ExploreEmbedded/Ultra--AT89S52-Development-Board_DVB-11001/Ultra 8051 Development Board V1.1_BOM .xls

Id | Designation | Designator | Package |  | Quantity
1 | 32.768KHz Crystal | X1 | Through hole | 1 | 50
2 | 10K Trim Pot (Blue and white) | RV1,RV3 | RM-065-103 | 2 | 100
3 | USB Type B Right angle Female | J1 | USB type B Through hole | 1 | 50
4 | DC Power Jack | K4 | Through hole | 1 | 50
5 | 40 pin ZIP Socket | U7 | DIP-40 | 1 | 50
6 | 10K Resistor Array ( 9 pin) | RR6,RR4,RR2,RR3 | SIL-9 TH | 4 | 200
7 | 1K Resistor, 5% , 0.25W | R8,R7,R6,R5,R9,R10,R12 | Through hole | 7 | 350
8 | 0.1uF Capacitor (Disc) | C3,C4,C7 | Through hole | 3 | 150
9 | 22pF Capacitor (Disc) | C12,C11 | Through hole | 2 | 100
10 | 100uF/25V Capacitor | C2 | Electrolytic , TH | 1 | 50
11 | 1000uF/25V Capacitor | C1 | Electrolytic , TH | 1 | 50
12 | IN4007 Diode | D6,D5,D16 | Through hole | 3 | 150
13 | 16 Pin IC Base | IC1 | DIP 16 | 1 | 50
14 | RED LED | D3,D13,D12,D11,D10,D9,D8,D7,D14,D15,D2,D4 | LED-5MM | 12 | 600
15 | 470E Resistor, 5% , 0.25W | R2,R16,R27 | Through hole | 3 | 150
16 | 10K Resistor, 5% , 0.25W | R1,R17,R26 | Through hole | 3 | 150
17 | 2.2K Resistor, 5% , 0.25W | R19 | Through hole | 1 | 50
18 | 220E Resistor, 5% , 0.25W | R18,R13 | Through hole | 2 | 100
19 | LM35 Sensor | RV2 | TO-92 | 1 | 50
25 | 40Pin Male header | P13 | Through hole | 1 | 1pack
26 | Momentary Push tactile switch (12mm X 12mm X 8mm)big | SW18 | 4 pin Through hole | 1 | 50
27 | 1.5A Bridge Rectifier | D1 | 4 pin Through hole | 1 | 50
28 | 8 pin DIP Switch | S1 | DIP-16 | 1 | 50
29 | 16 pin Female header Straight | LCD1 | SIL-16 | 1 | 50
30 | 40 pin IC Base | AFF1,AFF2,AFF3,AFF4 | DIP-40 | 4 | 200
31 | 11.0592MHz Crystal | X3 | Through hole | 1 | 50
32 | 2Pin Push Tactile switch(Small round ) | SW2,SW3,SW4,SW5,SW6,SW7,SW8,SW9,SW10,SW11,SW12,SW13,SW14,SW15,SW16,SW17,SW19,SW20 | Through hole | 18 | 900
33 | Verticle 3 pin slide switch | SW1 | Through hole | 1 | 50
34 | LM7805 Regulator | U1 | TO-220 | 1 | 50
35 | 5V/10A Sugar Cube Relay (Black clolor) | K2,K1 | 5pin Through hole | 2 | 100
36 | Magnatic buzzer Small | SG1 | Through hole | 1 | 50
37 | Transistor BC557 | Q1 | TO92 | 1 | 50
38 | 4.7K Resistor, 5% , 0.25W | R11 | R4 | 1 | 50
39 | CP2102 | U10 | QFN-28 | 1 | 50
40 | Transistor BC548 | Q8,Q7,Q5,Q4,Q6,Q2,Q3 | TO92 | 7 | 350
41 | 7Pin Male header | P18 | Through hole | 1 | 50
42 | 3.3K Resistor, 5% , 0.25W | R14,R15,R4,R3, | Through hole | 4 | 200
43 | 2.2K Resistor, 5% , 0.25W | R20 | Through hole | 1 | 50
44 | 68E Resistor, 5% , 0.25W | R24,R23,R22,R21 | R4 | 4 | 200
45 | LDR | R25 | Through hole | 1 | 50
46 | 2 pin BBT Connetor | JP9,JP8 | MKDSN | 2 | 100
47 | 10 pin Right angle Box header(5X2) | P5 | Through hole | 1 | 50
48 | 8 pin IC Base | U2,U3,u5 | DIP-8 | 3 | 150
49 | Coin cell Battery holder(CR2032) | U4 | Through hole | 1 | 50
50 | 3 pin BBT Connector | JP2,JP3 | MKDSN | 2 | 100
51 | 28 Pin IC Base Wide | U6 | Broad DIP-28 | 1 | 50
52 | Heat sink TO-220 | HT1 | 2 Mounting hole | 1 | 50
 | IC's and other component
 | AT89S52 | U7 | DIP-40 | 1 | 50
 | ADC0809CCN | U6 | N28B | 1 | 50
 | 16X2 Green LCD | LCD1 | HD4470 based LCD | 1 | 10
 | Seven Segment ( 0.56") Common Anode | AFF1,AFF2,AFF3,AFF4 | 0.56" , TH | 4 | 200
 | CR2032 Coin cell | U4 |  | 1 | 50
 | 12V, 1A Adaptor |  |  |  | 50
