ExploreEmbedded/Ultra--AT89S52-Development-Board_DVB-11001/Ultra_DB_X51_v1.kicad_pcb

## KiCad design Ultra_DB_X51_v1.kicad_pcb (2016-12-07)

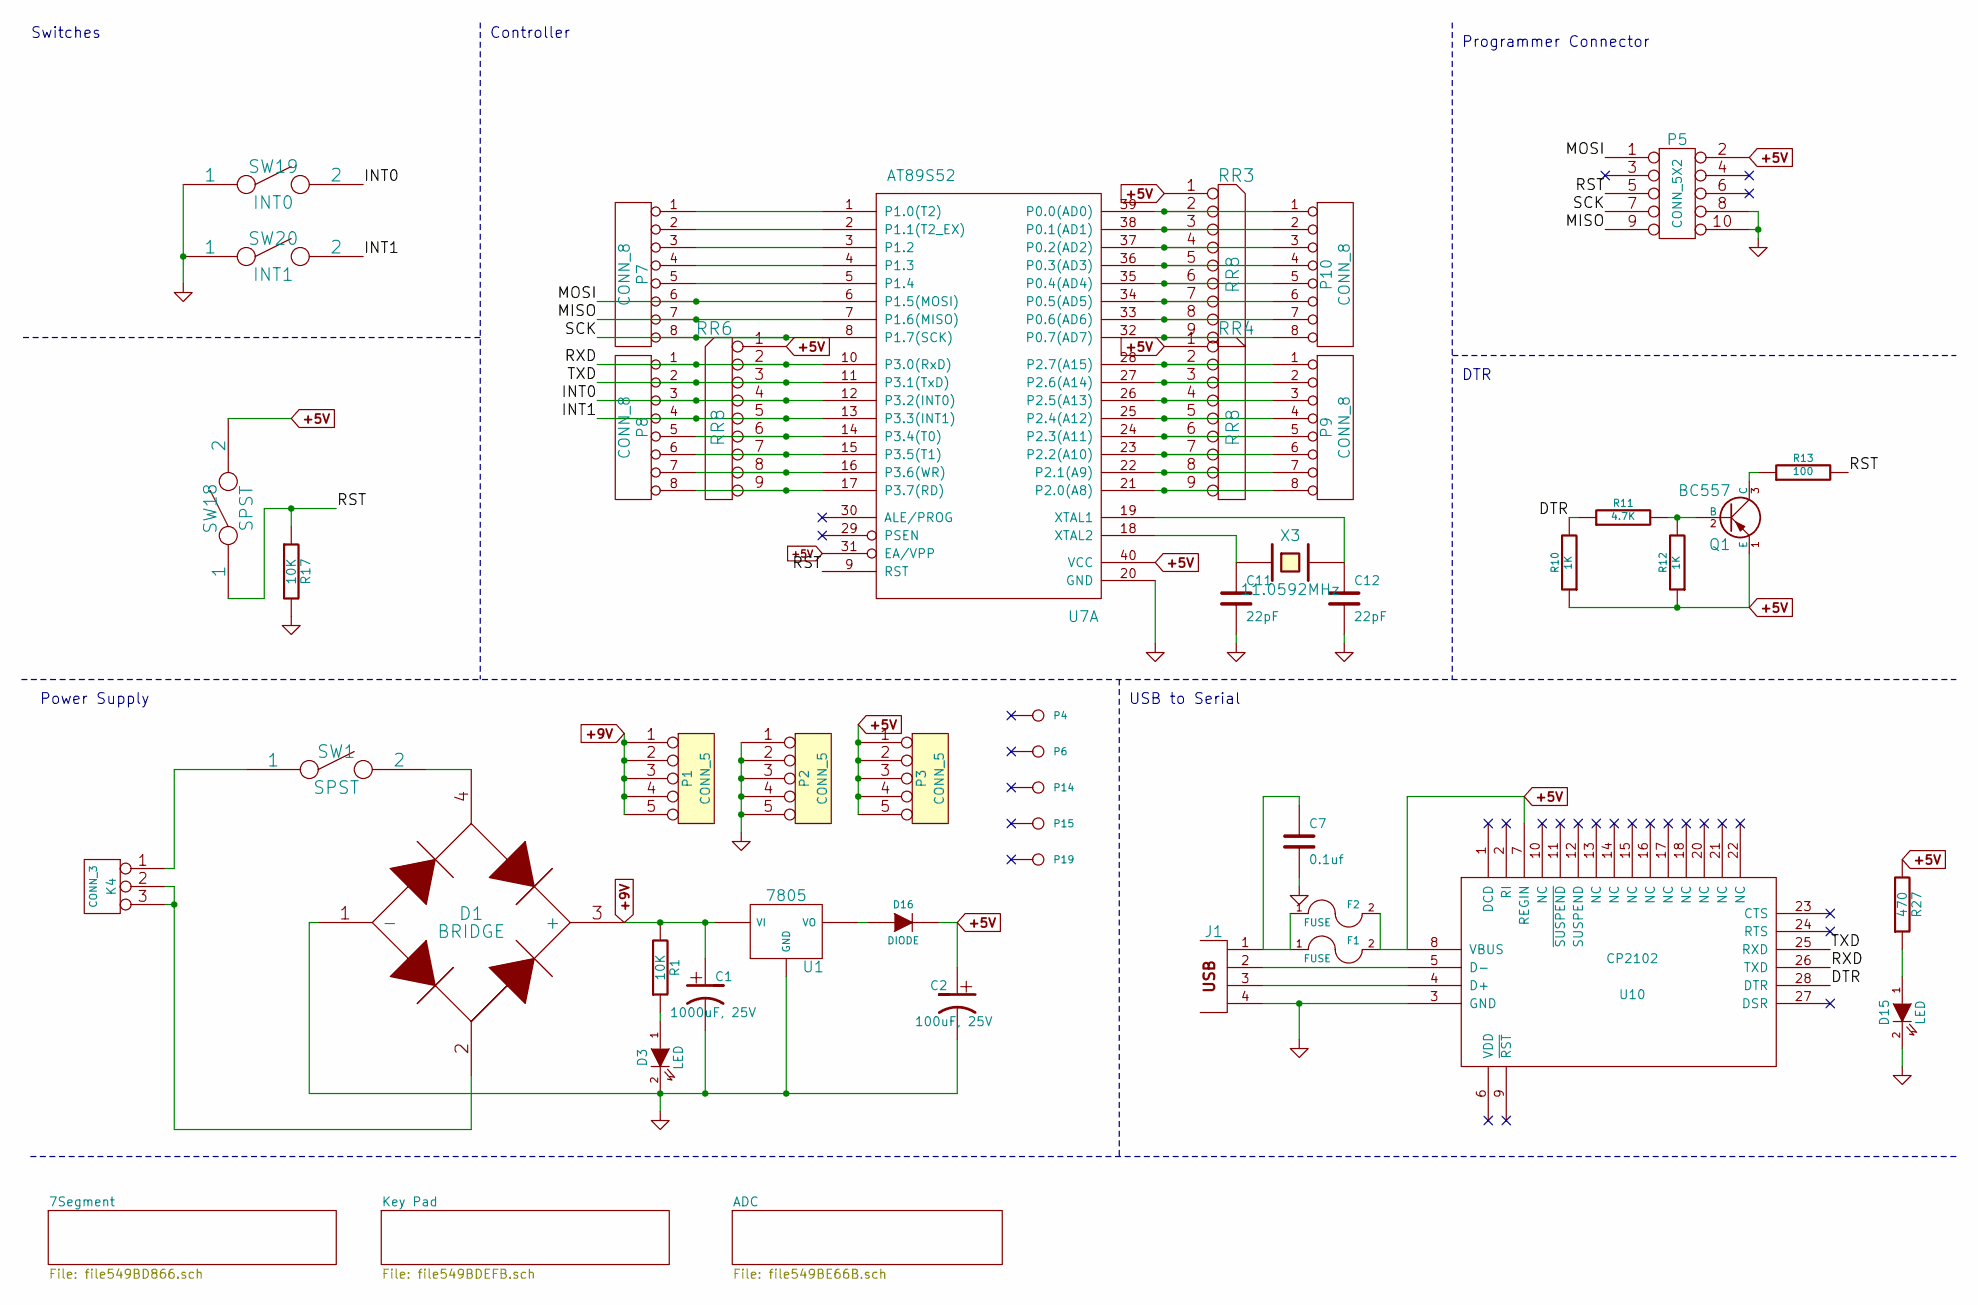
[picture p1: schematic Ultra_DB_X51_v1.sch, Schematic_Ultra_X51]

Parts:
C1: 1000uF, 25V
C2: 100uF, 25V
C7: 0.1uf
C11, C12: 22pF
D1: BRIDGE
D3, D15: LED
D16: DIODE
F1, F2: FUSE
J1: USB_2
K4: CONN_3
P1, P2, P3: CONN_5
P4, P6, P14, P15, P19: CONN_1
P5: CONN_5X2
P7, P8, P9, P10: CONN_8
Q1: BC557
R1, R17: 10K
R10, R12: 1K
R11: 4.7K
R13: 100
R27: 470
RR3, RR4, RR6: RR8
SW1, SW18: SPST
SW19: INT0
SW20: INT1
U1: 7805
U7: AT89S52
U10: CP2102; MODULE
X3: 11.0592MHz

Connections:
+5V: C2.1, D16.2 (K), F1.2, F2.2, P3.1, P3.2, P3.3, P3.4, P3.5, P5.2, Q1.1 (E), R10.1, R12.1, R27.2, RR3.1 (COM), RR4.1 (COM), RR6.1 (COM), SW18.2, U7.31 (EA/VPP), U7.40 (VCC), U10.7 (REGIN), U10.8 (VBUS); also elsewhere on the board
+9V: C1.1, D1.3 (+), P1.1, P1.2, P1.3, P1.4, P1.5, R1.2, U1.VI; also elsewhere on the board
/DTR: R10.2, R11.1, U10.28 (DTR)
/INT0: P8.3, RR6.4, SW19.2, U7.12 (P3.2(INT0))
/INT1: P8.4, RR6.5, SW20.2, U7.13 (P3.3(INT1))
/MISO: P5.9, P7.7, U7.7 (P1.6(MISO))
/MOSI: P5.1, P7.6, U7.6 (P1.5(MOSI))
/RST: P5.5, R13.2, R17.1, SW18.1, U7.9 (RST)
/RXD: P8.1, RR6.2, U7.10 (P3.0(RxD)), U10.26 (TXD)
/SCK: P5.7, P7.8, U7.8 (P1.7(SCK))
/TXD: P8.2, RR6.3, U7.11 (P3.1(TxD)), U10.25 (RXD)
GND: C1.2, C2.2, C7.2, C11.2, C12.2, D1.1 (-), D3.2 (K), D15.2 (K), J1.4, P2.1, P2.2, P2.3, P2.4, P2.5, P5.8, P5.10, R17.2, SW19.1, SW20.1, U1.GND, U7.20 (GND), U10.3 (GND); also elsewhere on the board
unnamed: J1.2, U10.5 (D-)
unnamed: Q1.2 (B), R11.2, R12.2
unnamed: J1.3, U10.4 (D+)
unnamed: Q1.3 (C), R13.1
unnamed: C7.1, F1.1, F2.1, J1.1
unnamed: D1.2, K4.2 (PM), K4.3
unnamed: P7.5, U7.5 (P1.4)
unnamed: P7.4, U7.4 (P1.3)
unnamed: P7.3, U7.3 (P1.2)
unnamed: P7.2, U7.2 (P1.1(T2_EX))
unnamed: P7.1, U7.1 (P1.0(T2))
unnamed: D16.1 (A), U1.VO
unnamed: C12.1, U7.19 (XTAL1), X3.2
unnamed: C11.1, U7.18 (XTAL2), X3.1
unnamed: D3.1 (A), R1.1
unnamed: D15.1 (A), R27.1
unnamed: K4.1, SW1.1
unnamed: D1.4, SW1.2
unnamed: P8.5, RR6.6, U7.14 (P3.4(T0))
unnamed: P8.8, RR6.9, U7.17 (P3.7(RD))
unnamed: P8.7, RR6.8, U7.16 (P3.6(WR))
unnamed: P8.6, RR6.7, U7.15 (P3.5(T1))
unnamed: P9.8, RR4.9, U7.21 (P2.0(A8))
unnamed: P9.7, RR4.8, U7.22 (P2.1(A9))
unnamed: P9.6, RR4.7, U7.23 (P2.2(A10))
unnamed: P9.5, RR4.6, U7.24 (P2.3(A11))
unnamed: P9.4, RR4.5, U7.25 (P2.4(A12))
unnamed: P9.3, RR4.4, U7.26 (P2.5(A13))
unnamed: P9.2, RR4.3, U7.27 (P2.6(A14))
unnamed: P9.1, RR4.2, U7.28 (P2.7(A15))
unnamed: P10.2, RR3.3, U7.38 (P0.1(AD1))
unnamed: P10.8, RR3.9, U7.32 (P0.7(AD7))
unnamed: P10.7, RR3.8, U7.33 (P0.6(AD6))
unnamed: P10.6, RR3.7, U7.34 (P0.5(AD5))
unnamed: P10.5, RR3.6, U7.35 (P0.4(AD4))
unnamed: P10.4, RR3.5, U7.36 (P0.3(AD3))
unnamed: P10.3, RR3.4, U7.37 (P0.2(AD2))
unnamed: P10.1, RR3.2, U7.39 (P0.0(AD0))

Notes on the sheet:
Switches
Controller
Programmer Connector
DTR
USB to Serial
Power Supply

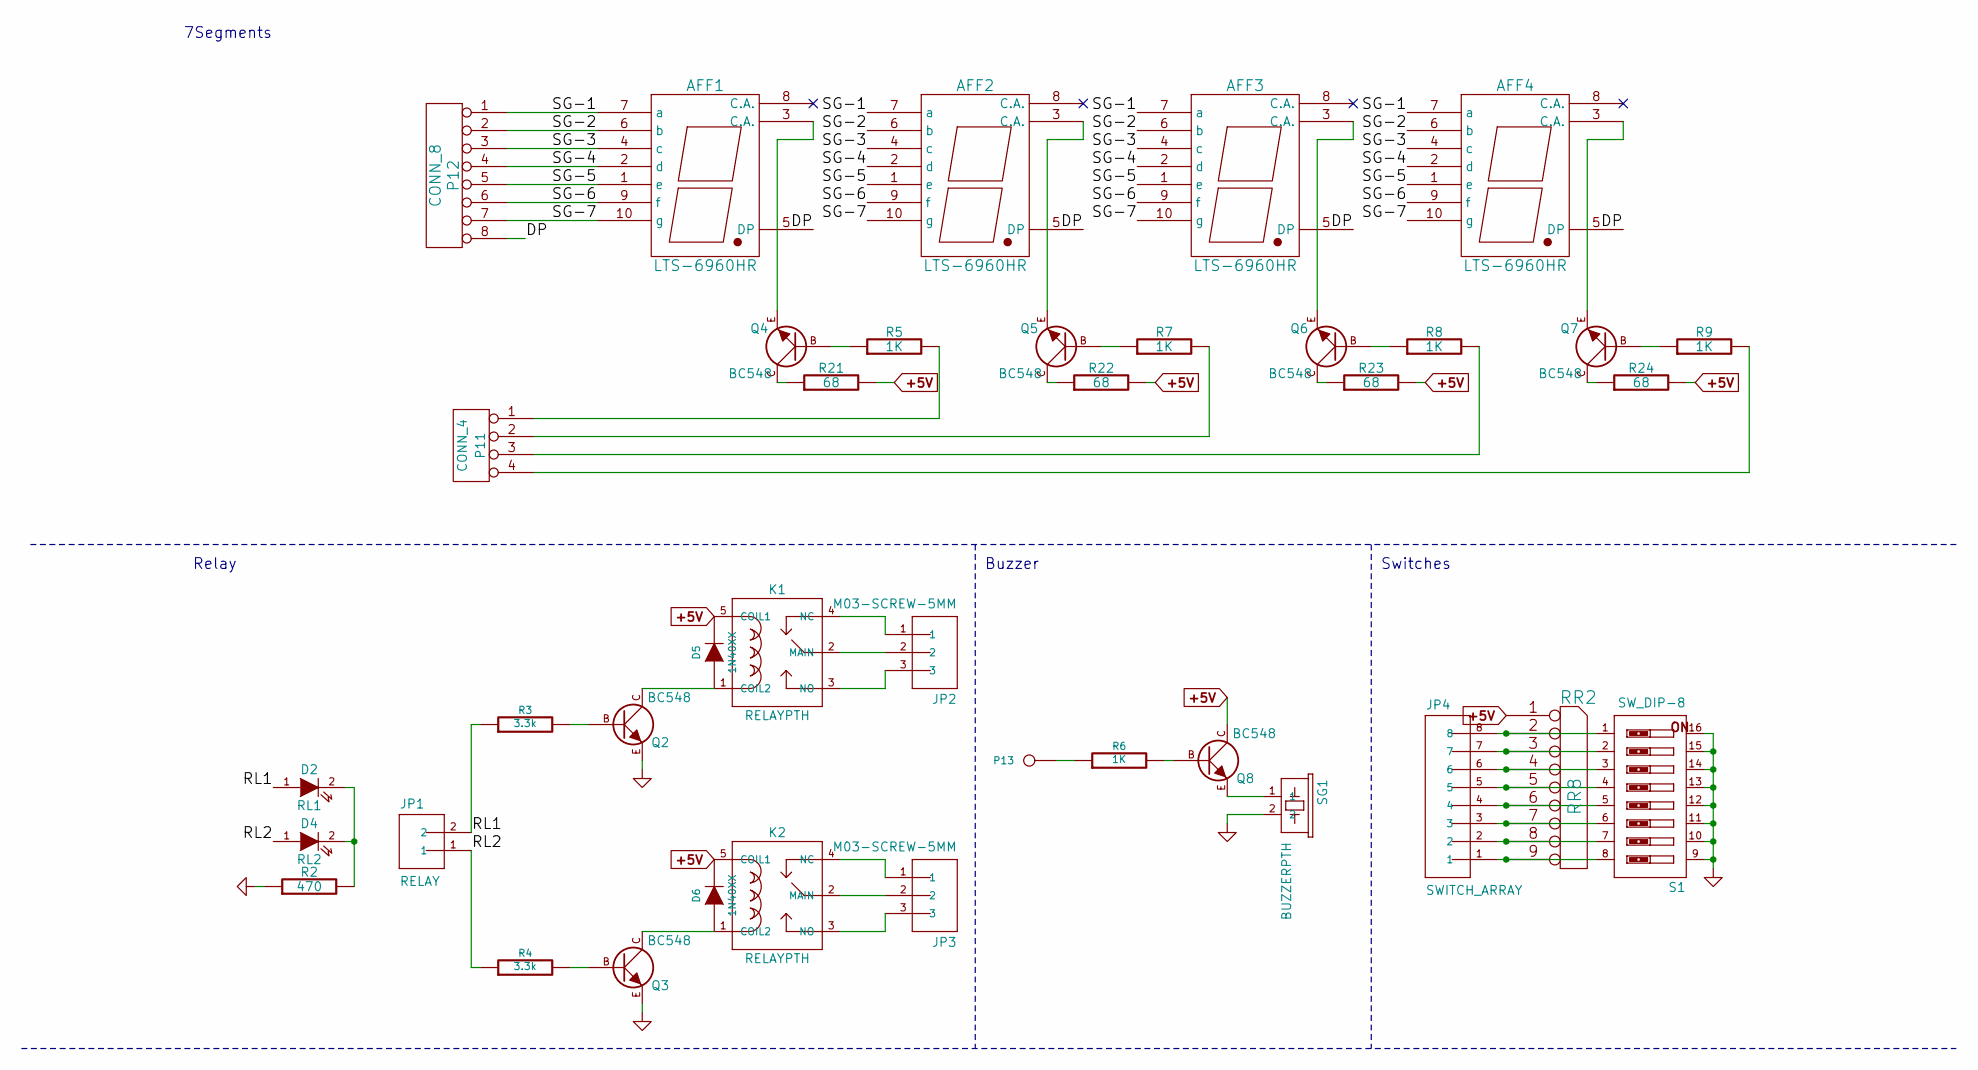
[picture p2: schematic file549BD866.sch]

Parts:
AFF1, AFF2, AFF3, AFF4: LTS-6960HR
D2: RL1
D4: RL2
D5, D6: 1N40XX
JP1: RELAY; SparkFun-JST-2-PTH-NS
JP2, JP3: M03-SCREW-5MM; SparkFun-SCREWTERMINAL-5MM-3
JP4: SWITCH_ARRAY; SparkFun-1X08_LOCK
K1, K2: RELAYPTH
P11: CONN_4
P12: CONN_8
P13: CONN_1
Q2, Q3, Q4, Q5, Q6, Q7, Q8: BC548; TO92-EBC
R2: 470
R3, R4: 3.3k
R5, R7, R8, R9: 1K
R6: 1K
R21, R22, R23, R24: 68
RR2: RR8
S1: SW_DIP-8; SparkFun-DIPSWITCH-08
SG1: BUZZERPTH; SparkFun-BUZZER-12MM

Connections:
+5V: D5.2 (K), D6.2 (K), K1.5 (COIL1), K2.5 (COIL1), Q8.C, R21.2, R22.2, R23.2, R24.2, RR2.1 (COM); also elsewhere on the board
/7Segment/DP: AFF1.5 (DP), AFF2.5 (DP), AFF3.5 (DP), AFF4.5 (DP), P12.8
/7Segment/RL1: D2.1 (A), JP1.2, R3.1
/7Segment/RL2: D4.1 (A), JP1.1, R4.1
/7Segment/SG-1: AFF1.7 (a), AFF2.7 (a), AFF3.7 (a), AFF4.7 (a), P12.1
/7Segment/SG-2: AFF1.6 (b), AFF2.6 (b), AFF3.6 (b), AFF4.6 (b), P12.2
/7Segment/SG-3: AFF1.4 (c), AFF2.4 (c), AFF3.4 (c), AFF4.4 (c), P12.3
/7Segment/SG-4: AFF1.2 (d), AFF2.2 (d), AFF3.2 (d), AFF4.2 (d), P12.4
/7Segment/SG-5: AFF1.1 (e), AFF2.1 (e), AFF3.1 (e), AFF4.1 (e), P12.5
/7Segment/SG-6: AFF1.9 (f), AFF2.9 (f), AFF3.9 (f), AFF4.9 (f), P12.6
/7Segment/SG-7: AFF1.10 (g), AFF2.10 (g), AFF3.10 (g), AFF4.10 (g), P12.7
GND: Q2.E, Q3.E, R2.1, S1.9, S1.10, S1.11, S1.12, S1.13, S1.14, S1.15, S1.16, SG1.2; also elsewhere on the board
unnamed: Q2.B, R3.2
unnamed: Q3.B, R4.2
unnamed: D6.1 (A), K2.1 (COIL2), Q3.C
unnamed: P11.1, R5.2
unnamed: D5.1 (A), K1.1 (COIL2), Q2.C
unnamed: P11.4, R9.2
unnamed: P11.3, R8.2
unnamed: P11.2, R7.2
unnamed: Q8.E, SG1.1
unnamed: Q8.B, R6.2
unnamed: P13.1, R6.1
unnamed: AFF4.3 (C.A.), Q7.E
unnamed: Q7.C, R24.1
unnamed: Q6.C, R23.1
unnamed: Q5.C, R22.1
unnamed: Q4.C, R21.1
unnamed: AFF2.3 (C.A.), Q5.E
unnamed: JP2.3, K1.3 (NO)
unnamed: JP2.2, K1.2 (MAIN)
unnamed: JP2.1, K1.4 (NC)
unnamed: JP4.8, RR2.2, S1.1
unnamed: JP3.1, K2.4 (NC)
unnamed: JP3.2, K2.2 (MAIN)
unnamed: D2.2 (K), D4.2 (K), R2.2
unnamed: JP4.1, RR2.9, S1.8
unnamed: JP4.2, RR2.8, S1.7
unnamed: JP4.3, RR2.7, S1.6
unnamed: JP4.4, RR2.6, S1.5
unnamed: JP4.5, RR2.5, S1.4
unnamed: JP4.6, RR2.4, S1.3
unnamed: JP4.7, RR2.3, S1.2
unnamed: JP3.3, K2.3 (NO)
unnamed: Q6.B, R8.1
unnamed: Q7.B, R9.1
unnamed: Q4.B, R5.1
unnamed: Q5.B, R7.1
unnamed: AFF1.3 (C.A.), Q4.E
unnamed: AFF3.3 (C.A.), Q6.E

Notes on the sheet:
7Segments
Relay
Buzzer
Switches

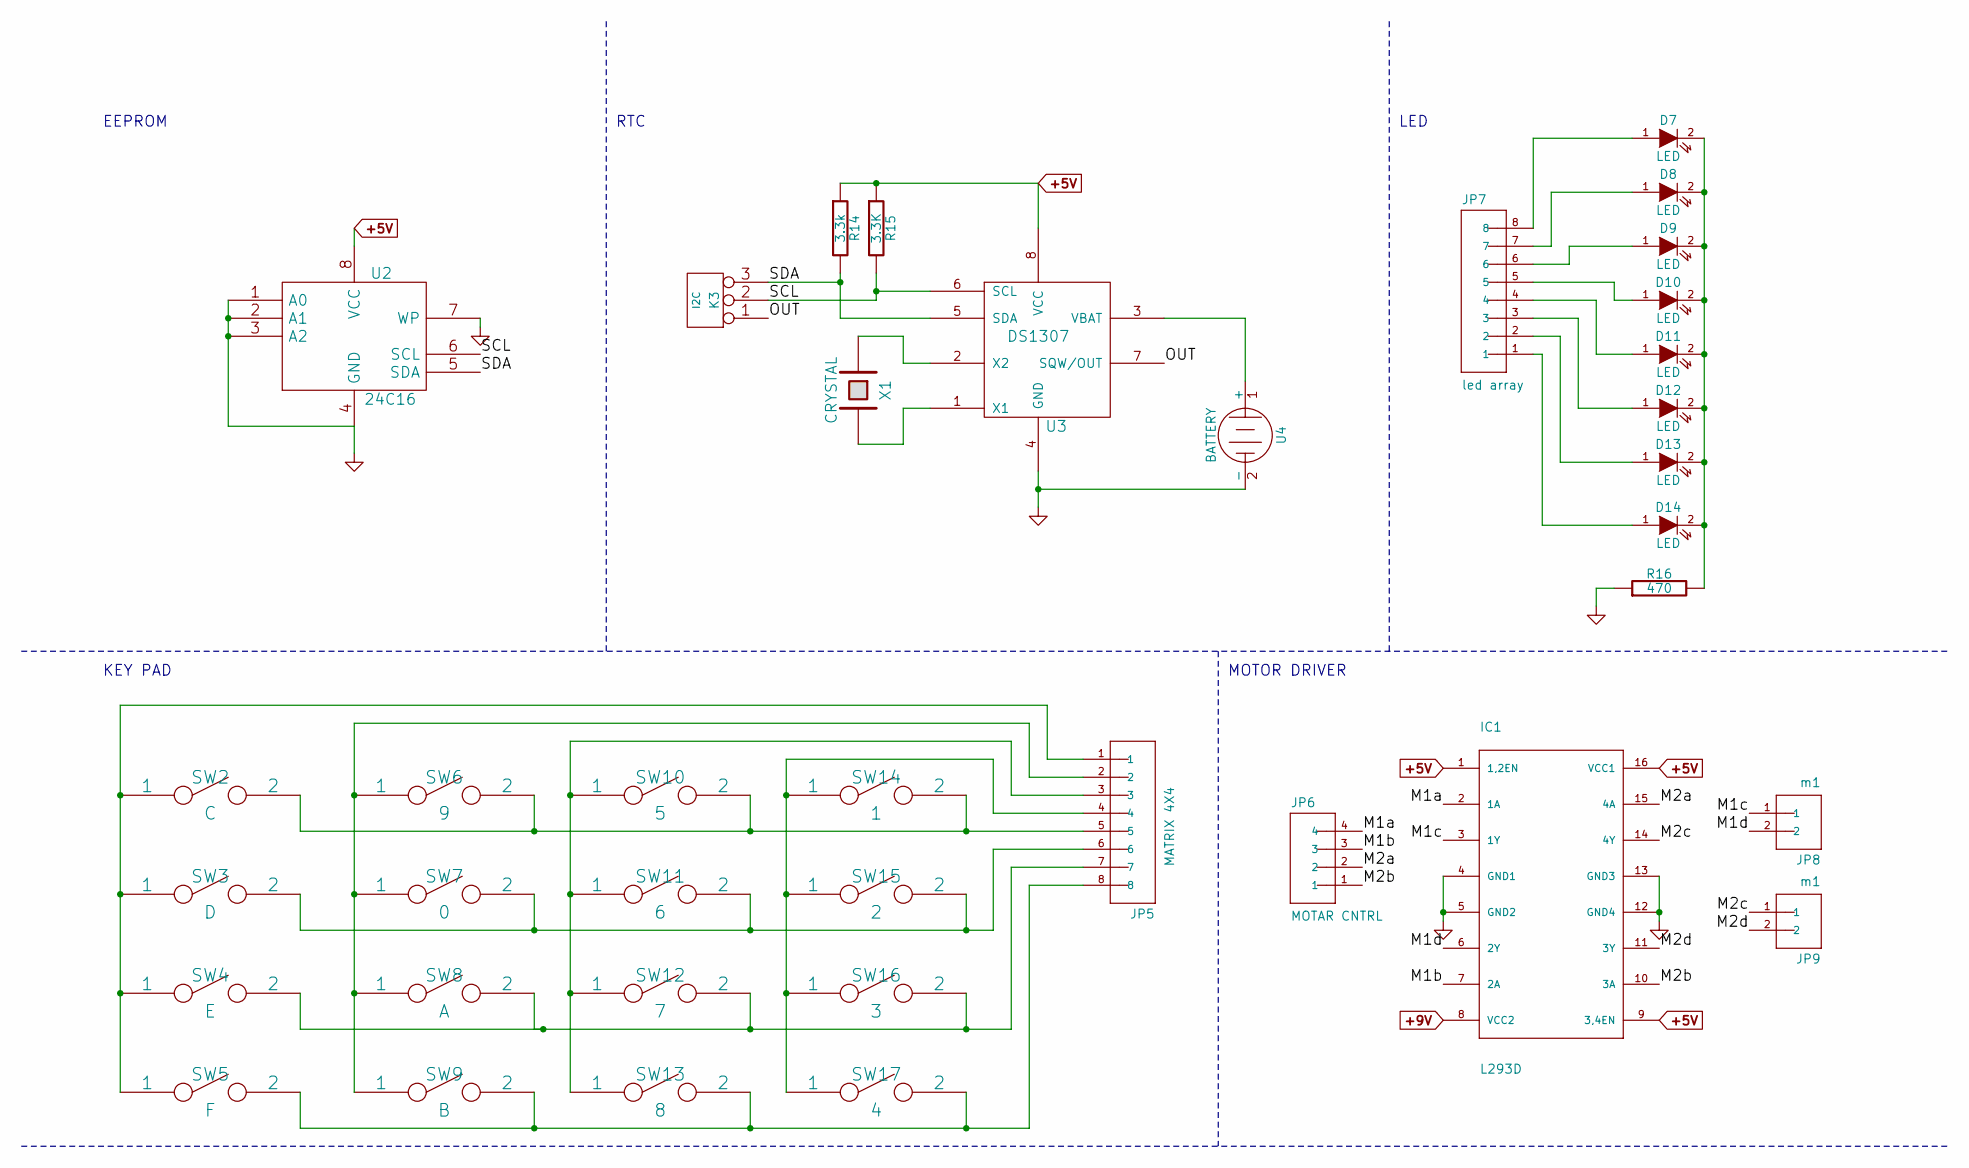
[picture p3: schematic file549BDEFB.sch]

Parts:
D7, D8, D9, D10, D11, D12, D13, D14: LED
IC1: L293D; sgs-thom-DIL16
JP5: MATRIX 4X4; SparkFun-1X08_LOCK
JP6: MOTAR CNTRL; SparkFun-JST-4-PTH
JP7: led array; SparkFun-1X08_LOCK
JP8, JP9: m1; SparkFun-JST-2-PTH-NS
K3: I2C
R14: 3.3k
R15: 3.3K
R16: 470
SW2: C
SW3: D
SW4: E
SW5: F
SW6: 9
SW7: 0
SW8: A
SW9: B
SW10: 5
SW11: 6
SW12: 7
SW13: 8
SW14: 1
SW15: 2
SW16: 3
SW17: 4
U2: 24C16
U3: DS1307
U4: BATTERY
X1: CRYSTAL

Connections:
+5V: IC1.1 (1,2EN), IC1.9 (3,4EN), IC1.16 (VCC1), R14.1, R15.1, U2.8 (VCC), U3.8 (VCC); also elsewhere on the board
+9V: IC1.8 (VCC2); also elsewhere on the board
/Key Pad/M1a: IC1.2 (1A), JP6.4
/Key Pad/M1b: IC1.7 (2A), JP6.3
/Key Pad/M1c: IC1.3 (1Y), JP8.1
/Key Pad/M1d: IC1.6 (2Y), JP8.2
/Key Pad/M2a: IC1.15 (4A), JP6.2
/Key Pad/M2b: IC1.10 (3A), JP6.1
/Key Pad/M2c: IC1.14 (4Y), JP9.1
/Key Pad/M2d: IC1.11 (3Y), JP9.2
/Key Pad/OUT: K3.1, U3.7 (SQW/OUT)
/Key Pad/SCL: K3.2 (PM), R15.2, U2.6 (SCL), U3.6 (SCL)
/Key Pad/SDA: K3.3, R14.2, U2.5 (SDA), U3.5 (SDA)
GND: IC1.4 (GND1), IC1.5 (GND2), IC1.12 (GND4), IC1.13 (GND3), R16.1, U2.1 (A0), U2.2 (A1), U2.3 (A2), U2.4 (GND), U2.7 (WP), U3.4 (GND), U4.2 (-); also elsewhere on the board
unnamed: D8.1 (A), JP7.7
unnamed: D9.1 (A), JP7.6
unnamed: D10.1 (A), JP7.5
unnamed: D11.1 (A), JP7.4
unnamed: D12.1 (A), JP7.3
unnamed: D13.1 (A), JP7.2
unnamed: D7.1 (A), JP7.8
unnamed: U3.2 (X2), X1.1
unnamed: U3.1 (X1), X1.2
unnamed: U3.3 (VBAT), U4.1 (+)
unnamed: D14.1 (A), JP7.1
unnamed: JP5.7, SW4.2, SW8.2, SW12.2, SW16.2
unnamed: JP5.8, SW5.2, SW9.2, SW13.2, SW17.2
unnamed: JP5.5, SW2.2, SW6.2, SW10.2, SW14.2
unnamed: JP5.6, SW3.2, SW7.2, SW11.2, SW15.2
unnamed: JP5.3, SW10.1, SW11.1, SW12.1, SW13.1
unnamed: JP5.2, SW6.1, SW7.1, SW8.1, SW9.1
unnamed: JP5.4, SW14.1, SW15.1, SW16.1, SW17.1
unnamed: JP5.1, SW2.1, SW3.1, SW4.1, SW5.1
unnamed: D7.2 (K), D8.2 (K), D9.2 (K), D10.2 (K), D11.2 (K), D12.2 (K), D13.2 (K), D14.2 (K), R16.2

Notes on the sheet:
EEPROM
RTC
LED
KEY PAD
MOTOR DRIVER

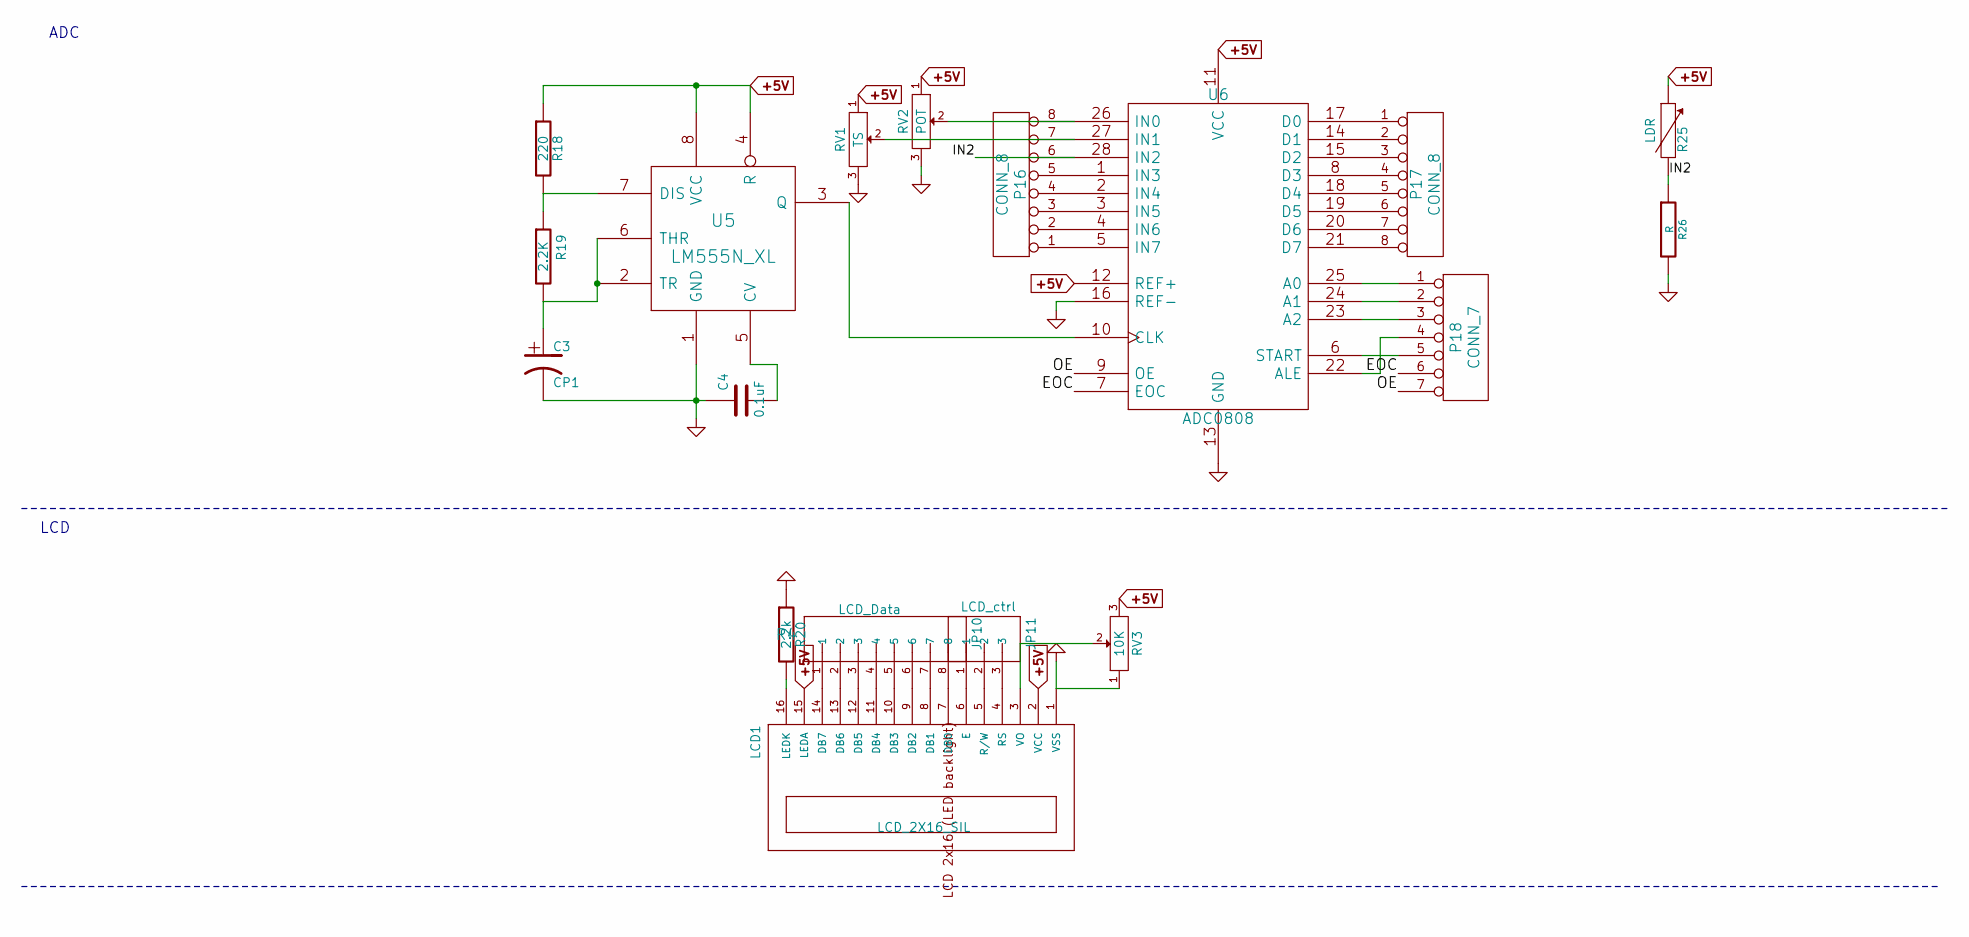
[picture p4: schematic file549BE66B.sch]

Parts:
C3: CP1
C4: 0.1uF
JP10: LCD_Data; SparkFun-1X08
JP11: LCD_ctrl; SparkFun-SCREWTERMINAL-5MM-3
LCD1: LCD_2X16_SIL; lcd_2x16_led_backlight-HY-1602F
P16, P17: CONN_8
P18: CONN_7
R18: 220
R19: 2.2K
R20: 2.2k; R4
R25: LDR
R26: R
RV1: TS
RV2: POT
RV3: 10K
U5: LM555N_XL
U6: ADC0808

Connections:
+5V: LCD1.2 (VCC), LCD1.15 (LEDA), R18.1, R25.1, RV1.1, RV2.1, RV3.3, U5.4 (R), U5.8 (VCC), U6.11 (VCC), U6.12 (REF+); also elsewhere on the board
/ADC/EOC: P18.6, U6.7 (EOC)
/ADC/IN2: P16.6, R25.2, R26.1, U6.28 (IN2)
/ADC/OE: P18.7, U6.9 (OE)
GND: C3.2, C4.1, LCD1.1 (VSS), R20.1, R26.2, RV1.3, RV2.3, RV3.1, U5.1 (GND), U6.13 (GND), U6.16 (REF-); also elsewhere on the board
unnamed: LCD1.16 (LEDK), R20.2
unnamed: JP11.1, LCD1.6 (E)
unnamed: JP10.1, LCD1.14 (DB7)
unnamed: JP11.2, LCD1.5 (R/W)
unnamed: JP11.3, LCD1.4 (RS)
unnamed: P18.5, U6.6 (START)
unnamed: P18.4, U6.22 (ALE)
unnamed: JP10.2, LCD1.13 (DB6)
unnamed: JP10.3, LCD1.12 (DB5)
unnamed: JP10.4, LCD1.11 (DB4)
unnamed: JP10.5, LCD1.10 (DB3)
unnamed: JP10.6, LCD1.9 (DB2)
unnamed: JP10.7, LCD1.8 (DB1)
unnamed: JP10.8, LCD1.7 (DB0)
unnamed: C4.2, U5.5 (CV)
unnamed: R18.2, R19.1, U5.7 (DIS)
unnamed: P18.3, U6.23 (A2)
unnamed: P16.8, RV2.2, U6.26 (IN0)
unnamed: P16.7, RV1.2, U6.27 (IN1)
unnamed: U5.3 (Q), U6.10 (CLK)
unnamed: P18.1, U6.25 (A0)
unnamed: P18.2, U6.24 (A1)
unnamed: LCD1.3 (VO), RV3.2
unnamed: P17.2, U6.14 (D1)
unnamed: P17.3, U6.15 (D2)
unnamed: P17.1, U6.17 (D0)
unnamed: P17.5, U6.18 (D4)
unnamed: P17.6, U6.19 (D5)
unnamed: C3.1, R19.2, U5.2 (TR), U5.6 (THR)
unnamed: P16.2, U6.4 (IN6)
unnamed: P16.5, U6.1 (IN3)
unnamed: P16.4, U6.2 (IN4)
unnamed: P16.3, U6.3 (IN5)
unnamed: P16.1, U6.5 (IN7)
unnamed: P17.4, U6.8 (D3)
unnamed: P17.7, U6.20 (D6)
unnamed: P17.8, U6.21 (D7)

Notes on the sheet:
ADC
LCD

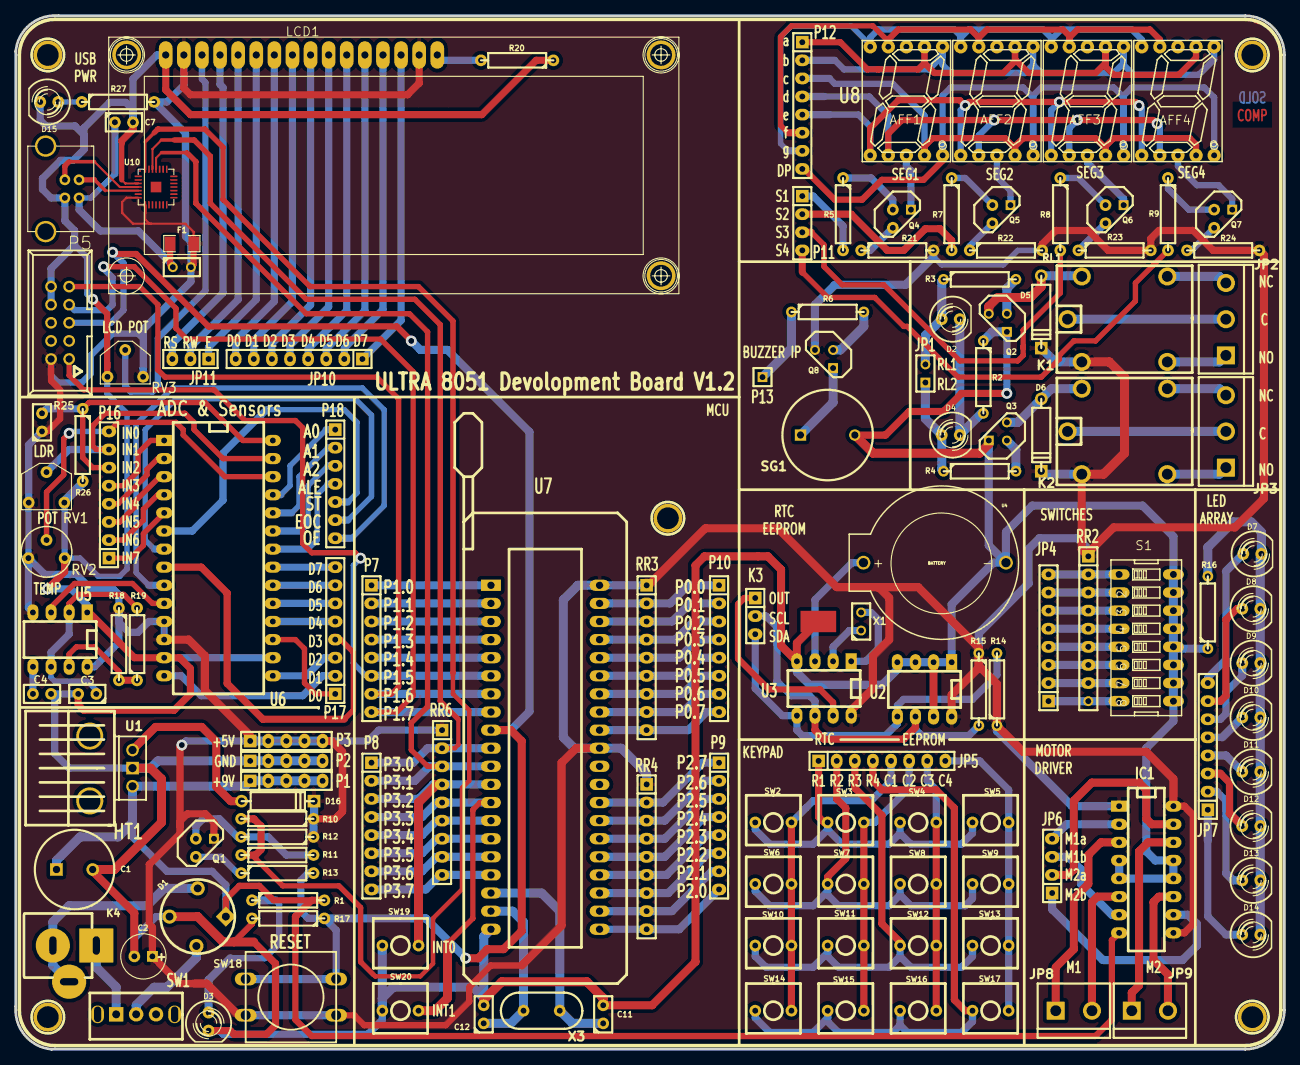
[picture p5: board Ultra_DB_X51_v1.kicad_pcb from above]

Board: 2 copper layers, 178.0 x 145.0 mm, 141 parts (1 on the bottom side), 169 nets.

Other parts of the board:
LOGO: LOGO (1)
