ExploreEmbedded/Ultra--AT89S52-Development-Board_DVB-11001/(commit log)

2015-09-25 filled zones
    [file549BDEFB.kicad_pcb]
2015-09-25 added name backside
    [Ultra_DB_X51_v1.kicad_pcb]
2016-01-19 Ver1.2
    1. Mounting holes for slide switch
    2. Nomenclature for all the ident.
    [Ultra 8051 Development Board V1.1_BOM .csv, Ultra 8051 Development Board V1.1_BOM .xls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]
2016-01-21 gerber file
    [Ultra_DB_X51_v1.kicad_pcb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]
2016-12-07 Gerber file generated
    [Ultra_DB_X51_v1-B.Mask.gbs, Ultra_DB_X51_v1-B.SilkS.gbo, Ultra_DB_X51_v1-B_Cu.gbl, Ultra_DB_X51_v1-B_Mask.gbs, Ultra_DB_X51_v1-B_SilkS.gbo, Ultra_DB_X51_v1-Back.gbl, Ultra_DB_X51_v1-F.Mask.gts, Ultra_DB_X51_v1-F.SilkS.gto]
